willwilder/mse-499-embedded/run graphs/All Runs.jpg

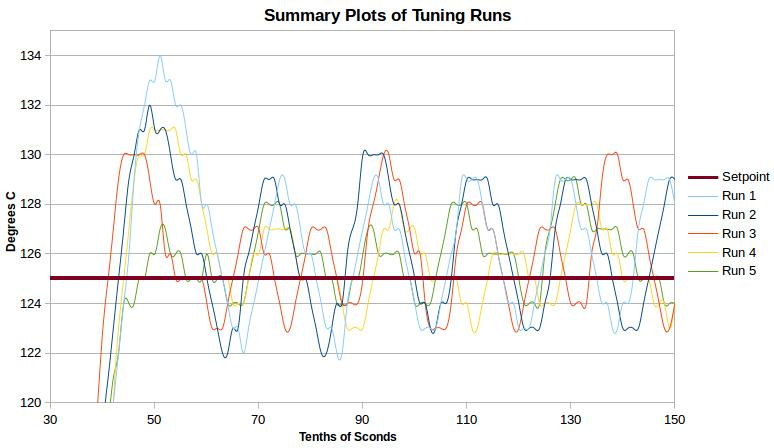
run graphs/All Runs.jpg
