willwilder/mse-499-embedded/run graphs/Perturbation.jpg

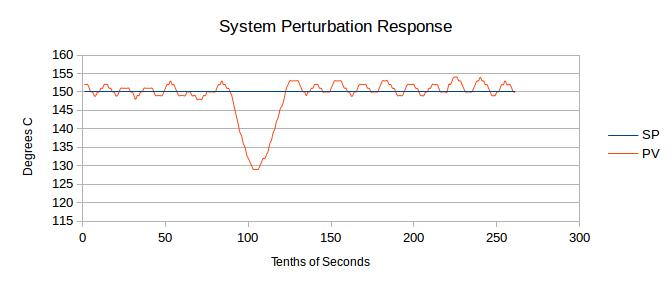
run graphs/Perturbation.jpg
