willwilder/mse-499-embedded/run graphs/Ramping Response.jpg

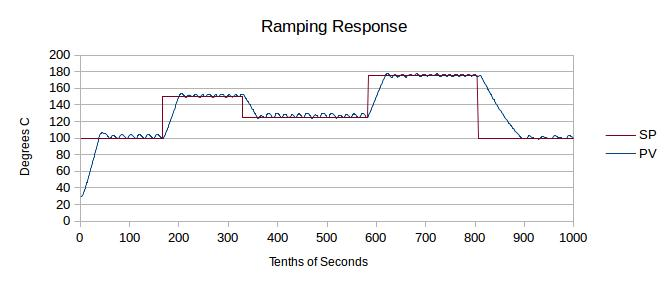
run graphs/Ramping Response.jpg
