willwilder/mse-499-embedded/run graphs/Run1.jpg

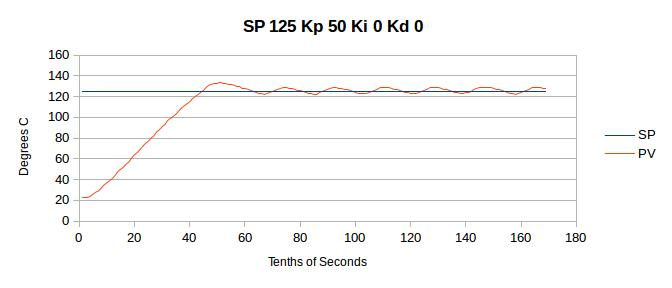
run graphs/Run1.jpg
