willwilder/mse-499-embedded/run graphs/Run2.jpg

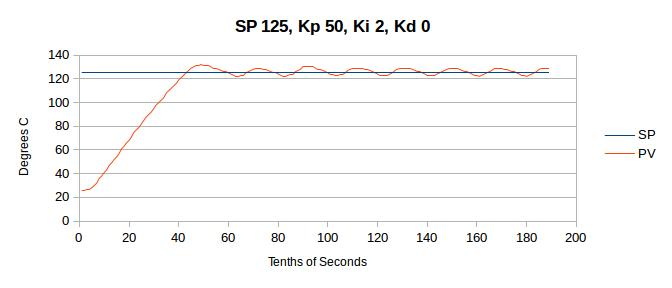
run graphs/Run2.jpg
