willwilder/mse-499-embedded/run graphs/Run3.jpg

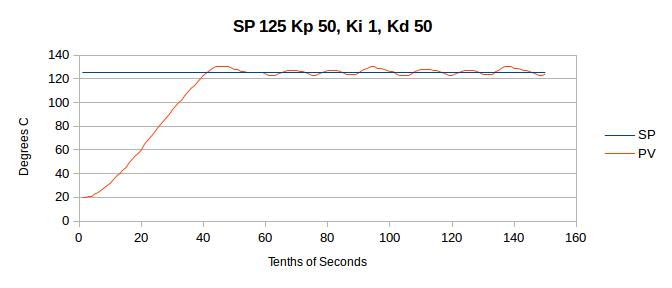
run graphs/Run3.jpg
