willwilder/mse-499-embedded/run graphs/Run5.jpg

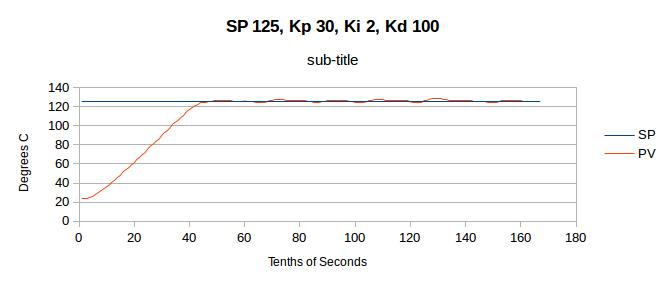
run graphs/Run5.jpg
