willwilder/mse-499-embedded/schematic/MSE Temp Controller.sch

## EAGLE design schematic/MSE Temp Controller.sch (2015-10-02)

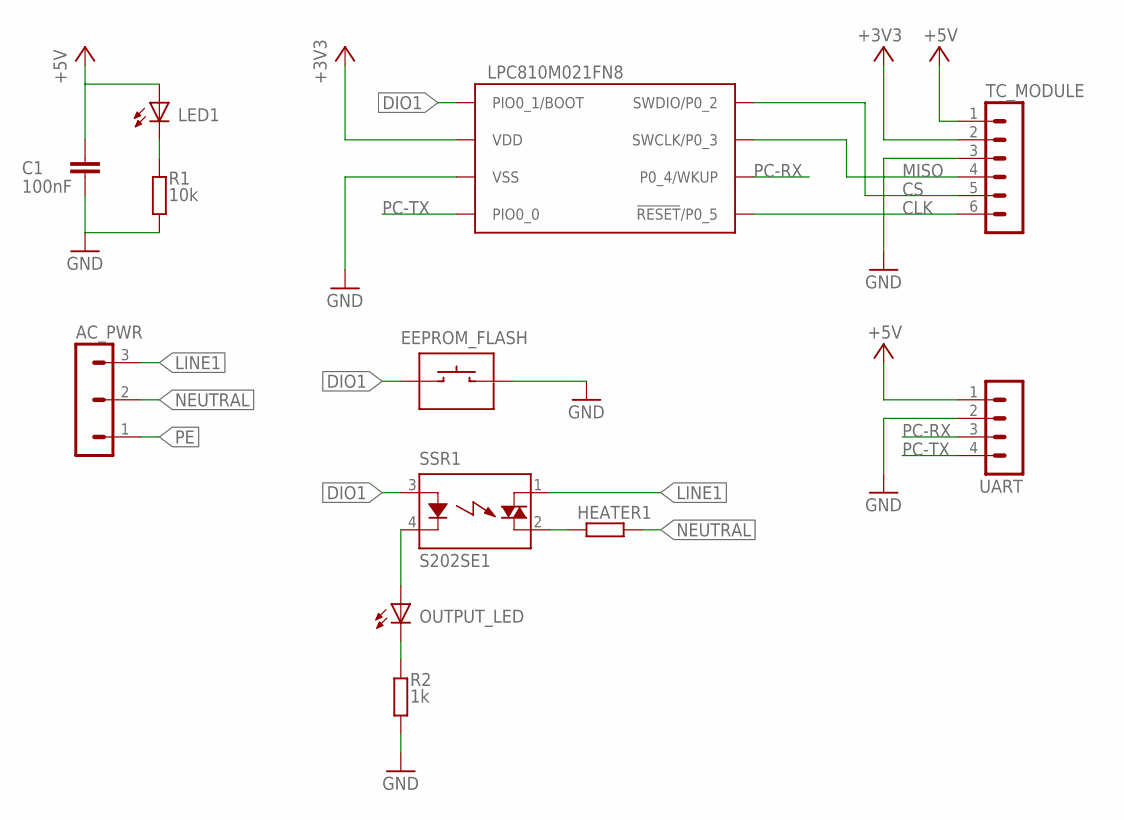
[picture p8: schematic MSE Temp Controller.sch]

Parts:
AC_PWR: MA03-1
C1: 100nF; C0603
D1, D2: CLM3C-WKW-CWBYA153; PLCC2
HEATER1: RR0402; R0402
R1: 10k; R0402
R2: 1k; R0402
S1: EVQ_Q2_Y01W; EVQQ2
SSR1: S202SE1; S2XXEX
TC_MODULE: MA06-1
U$1: LPC810M021FN8; DIP8
UART: MA04-1

Connections:
+3V3: TC_MODULE.2, U$1.P$6 (VDD)
+5V: C1.1, D2.P$1 (A), TC_MODULE.1, UART.1
CLK: TC_MODULE.6, U$1.P$1 (!RESET!/P0_5)
CS: TC_MODULE.5, U$1.P$4 (SWDIO/P0_2)
DIO1: S1.A1 (A), SSR1.3 (A), U$1.P$5 (PIO0_1/BOOT)
GND: C1.2, R1.1, R2.2, S1.B1 (B), TC_MODULE.3, U$1.P$7 (VSS), UART.2
LINE1: AC_PWR.3, SSR1.1 (DS1)
MISO: TC_MODULE.4, U$1.P$3 (SWCLK/P0_3)
unnamed: D2.P$2 (C), R1.2
unnamed: D1.P$1 (A), SSR1.4 (K)
unnamed: HEATER1.1, SSR1.2 (DS2)
unnamed: D1.P$2 (C), R2.1
NEUTRAL: AC_PWR.2, HEATER1.2
PC-RX: U$1.P$2 (P0_4/WKUP), UART.3
PC-TX: U$1.P$8 (PIO0_0), UART.4
PE: AC_PWR.1
