willwilder/mse-499-embedded/python/data/Production Runs 20151015/Test Tracking 20151015.ods

Goal | Max | Rise Time | Kp | Ki | Kd
Baseline | 134 | 4.5 | 50 | 1 | 0
Reduce Overshoot | 132 | 4.4 | 50 | 2 | 0
Reduce Overshoot | 130 | 4.2 | 50 | 1 | 50
Reduce Overshoot | 129 | 5.4 | 15 | 2 | 100
Improve Rise Time | 129 | 4.7 | 15 | 2 | 60
Improve Rise Time | 128 | 4.8 | 30 | 2 | 100
 |  |  | 30 | 2 | 60
