willwilder/mse-499-embedded/python/data/Production Runs 20151015/Test Tuning 20151015.ods

Sheet: Summary
Goal | Overshoot | Rise Time | Error Plus | Error Minus | Error Band | Kp | Ki | Kd
Baseline | 134 | 4.5 | 129 | 123 | 6 | 50 | 1 | 0
Reduce Overshoot | 132 | 4.4 | 130 | 122 | 8 | 50 | 2 | 0
Reduce Overshoot | 130 | 4.2 | 130 | 123 | 7 | 50 | 1 | 50
Tighten Error Band | 131 | 4.5 | 127 | 124 | 3 | 50 | 1 | 100
Reduce Overshoot | 128 | 4.8 | 127 | 124 | 3 | 30 | 2 | 100

Sheet: Kp50Ki1Kd0
ProcessRunning | SP | PV | Kp | Ki | Kd | Error | PError | Integral | Derivative | Output
1 | 125 | 23 | 50 | 1 | 0 | 102 | 102 | 10200 | 102 | 5100
1 | 125 | 23 | 50 | 1 | 0 | 102 | 102 | 20400 | 0 | 5100
1 | 125 | 23 | 50 | 1 | 0 | 102 | 102 | 30600 | 0 | 5100
1 | 125 | 24 | 50 | 1 | 0 | 101 | 101 | 40700 | -1 | 5050
1 | 125 | 26 | 50 | 1 | 0 | 99 | 99 | 50600 | -2 | 4950
1 | 125 | 28 | 50 | 1 | 0 | 97 | 97 | 60300 | -2 | 4850
1 | 125 | 29 | 50 | 1 | 0 | 96 | 96 | 69900 | -1 | 4800
1 | 125 | 32 | 50 | 1 | 0 | 93 | 93 | 79200 | -3 | 4650
1 | 125 | 35 | 50 | 1 | 0 | 90 | 90 | 88200 | -3 | 4500
1 | 125 | 37 | 50 | 1 | 0 | 88 | 88 | 97000 | -2 | 4400
1 | 125 | 39 | 50 | 1 | 0 | 86 | 86 | 105600 | -2 | 4300
1 | 125 | 41 | 50 | 1 | 0 | 84 | 84 | 114000 | -2 | 4200
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
