willwilder/mse-499-embedded/python/data/Production Runs 20151015/Test Tuning 20151015.xlsx

Sheet: Summary
 | PID Constants |  |  | Rise Observations |  | Steady State Observations
Run Objective | Kp | Ki | Kd | Overshoot | Rise Time | Error Plus | Error Minus | Error Band | Steady State Error
Baseline | 50 | 0 | 0 | 134 | 4.5 | 129 | 123 | 6 | 125.98
Reduce Overshoot | 50 | 2 | 0 | 132 | 4.4 | 130 | 122 | 8 | 126.13
Reduce Overshoot | 50 | 1 | 50 | 130 | 4.2 | 130 | 123 | 7 | 125.81
Tighten Error Band | 50 | 1 | 100 | 131 | 4.5 | 127 | 124 | 3 | 125.42
Reduce Overshoot | 30 | 2 | 100 | 128 | 4.8 | 127 | 124 | 3 | 125.89

Sheet: Kp50Ki1Kd0
ProcessRunning | SP | PV | Kp | Ki | Kd | Error | PError | Integral | Derivative | Output
1 | 125 | 23 | 50 | 0 | 0 | 102 | 102 | 10200 | 102 | 5100
1 | 125 | 23 | 50 | 0 | 0 | 102 | 102 | 20400 | 0 | 5100
1 | 125 | 23 | 50 | 0 | 0 | 102 | 102 | 30600 | 0 | 5100
1 | 125 | 24 | 50 | 0 | 0 | 101 | 101 | 40700 | -1 | 5050
1 | 125 | 26 | 50 | 0 | 0 | 99 | 99 | 50600 | -2 | 4950
1 | 125 | 28 | 50 | 0 | 0 | 97 | 97 | 60300 | -2 | 4850
1 | 125 | 29 | 50 | 0 | 0 | 96 | 96 | 69900 | -1 | 4800
1 | 125 | 32 | 50 | 0 | 0 | 93 | 93 | 79200 | -3 | 4650
1 | 125 | 35 | 50 | 0 | 0 | 90 | 90 | 88200 | -3 | 4500
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
