willwilder/mse-499-embedded/(commit log)

2015-10-15 Added data files for analysis
    [1444884842.19data.csv, 1444884858.27data.csv, 1444885969.94data.csv, 1444886159.3data.csv, 1444929052.04data.csv, 1444930898.78data.csv, 1444932643.76data.csv, 1444933041.05data.csv]
2015-10-15 removed open office file locks
    [Test Tuning 20151015.ods]
2015-10-16 export ods as xlsx
    [Test Tuning 20151015.xlsx]
2015-10-16 fixed bug calculating integral component of output
    [main.c]
2015-10-16 new files
    [Test Tuning 20151015.xlsx]
2015-10-23 python updates
    [1443655939.92data.csv, 1443655939.92data.ods, 1443656212.78data.csv, 1443656212.78data.ods, 1443656751.34data.csv, 1443658060.53data.csv, 1443658313.64data.csv, 1444884842.19data.csv]
2016-03-18 final commit
    [Kp1 Ki1 Kd0 1446572210.64.csv, Kp200 Ki0 Kd0 1446572159.07.csv, Kp200 Ki100 Kd170 1446513035.86.csv, Kp200 Ki100 Kd170 1446513063.41.csv, Kp200 Ki100 Kd170 1446513629.16.csv, Kp200 Ki100 Kd170 1446513773.78.csv, Kp200 Ki100 Kd170 1446571703.44.csv, Kp200 Ki100 Kd170 1446739753.02.csv]
